ray33ee/RadiatorController/readme.md

# RadiatorController

A home made WiFi operated radiator valve controller made using a Danfoss Eco enclosure and motor.
