ray33ee/RadiatorController/Front/front/front.kicad_pcb

## KiCad design Front/front/front.kicad_pcb (2021-11-04)

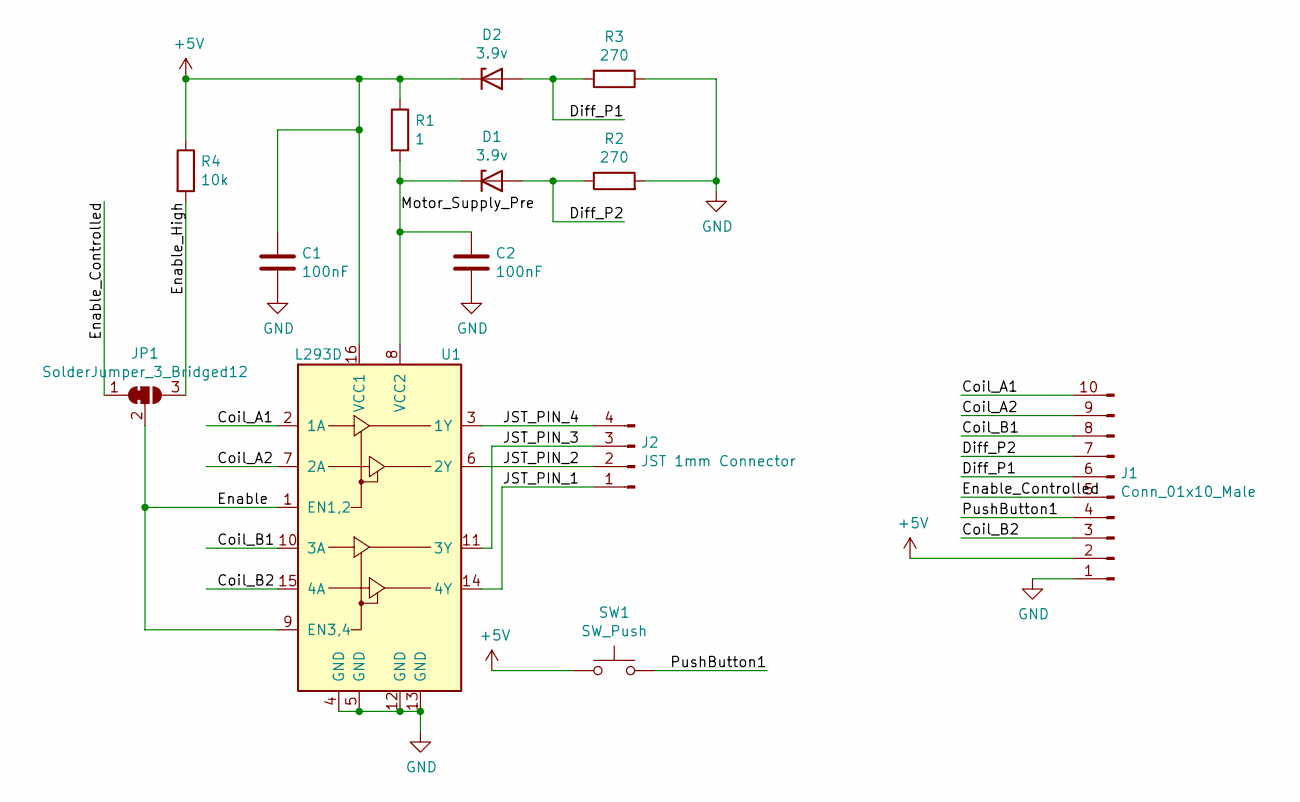
[picture p1: schematic front.sch]

Parts:
C1, C2: 100nF; C_1206_3216Metric_Pad1.33x1.80mm_HandSolder
D1, D2: 3.9v; D_MiniMELF
J1: Conn_01x10_Male; PinHeader_1x10_P2.54mm_Vertical
J2: JST 1mm Connector; JST_SH_SM04B-SRSS-TB_1x04-1MP_P1.00mm_Horizontal
JP1: SolderJumper_3_Bridged12; SolderJumper-3_P1.3mm_Bridged12_RoundedPad1.0x1.5mm_NumberL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
R1: 1; R_1206_3216Metric_Pad1.30x1.75mm_HandSolder
R2, R3: 270; R_1206_3216Metric_Pad1.30x1.75mm_HandSolder
R4: 10k; R_1206_3216Metric_Pad1.30x1.75mm_HandSolder
SW1: SW_Push; SW_Push_SPST_NO_Alps_SKRK
U1: L293D; DIP-16_W7.62mm

Connections:
+5V: C1.1, D2.1 (K), J1.2, R1.1, R4.1, SW1.1, U1.16 (VCC1)
/Coil_A1: J1.10, U1.2 (1A)
/Coil_A2: J1.9, U1.7 (2A)
/Coil_B1: J1.8, U1.10 (3A)
/Coil_B2: J1.3, U1.15 (4A)
/Diff_P1: D2.2 (A), J1.6, R3.2
/Diff_P2: D1.2 (A), J1.7, R2.1
/Enable: JP1.2 (C), U1.1 (EN1,2), U1.9 (EN3,4)
/Enable_Controlled: J1.5, JP1.1 (A)
/Enable_High: JP1.3 (B), R4.2
/JST_PIN_1: J2.1, U1.14 (4Y)
/JST_PIN_2: J2.2, U1.6 (2Y)
/JST_PIN_3: J2.3, U1.11 (3Y)
/JST_PIN_4: J2.4, U1.3 (1Y)
/Motor_Supply_Pre: C2.1, D1.1 (K), R1.2, U1.8 (VCC2)
/PushButton1: J1.4, SW1.2
GND: C1.2, C2.2, J1.1, R2.2, R3.1, U1.4 (GND), U1.5 (GND), U1.12 (GND), U1.13 (GND)

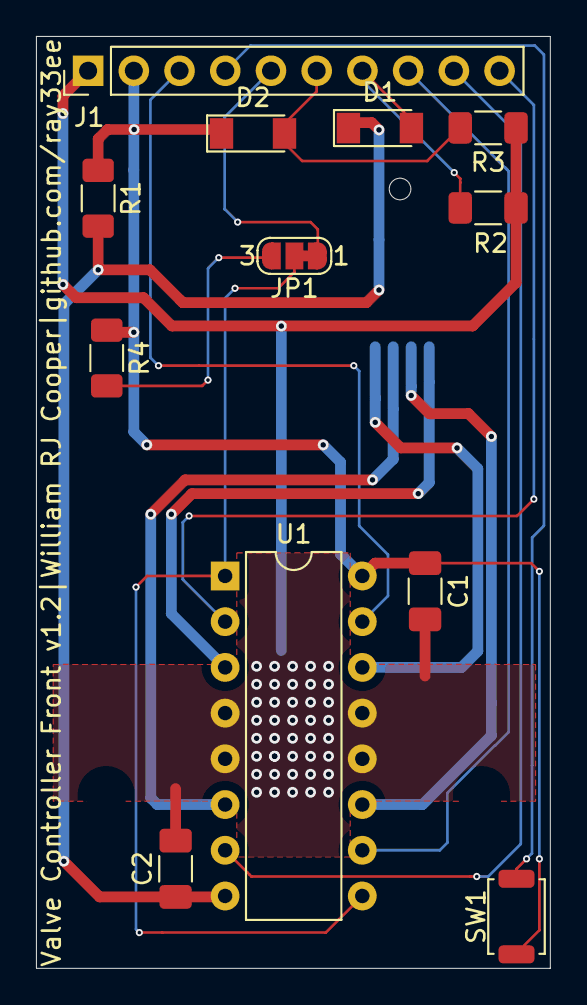
[picture p2: board front.kicad_pcb from above]

Board: 2 copper layers, 28.5 x 51.8 mm, 13 parts (1 on the bottom side), 17 nets.
