ray33ee/RadiatorController/Side/side/side.kicad_pcb

## KiCad design Side/side/side.kicad_pcb (2021-11-02)

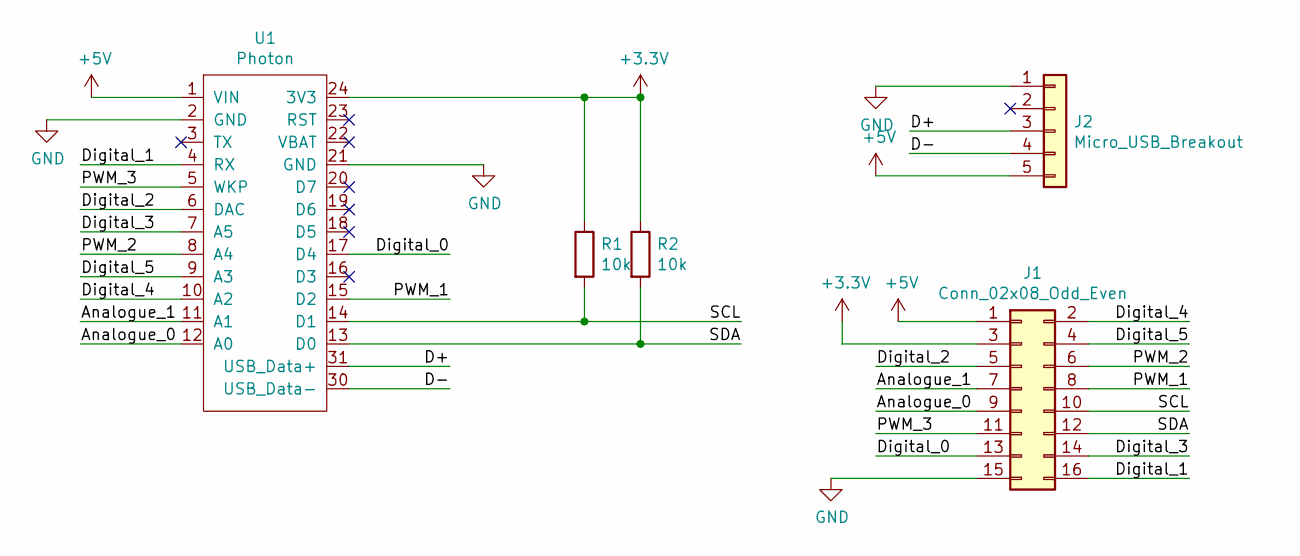
[picture p3: schematic side.sch]

Parts:
J1: Conn_02x08_Odd_Even; PinHeader_2x08_P2.54mm_Vertical
J2: Micro_USB_Breakout; Adafruit_Micro_USB_Breakout_copy
R1, R2: 10k; R_1206_3216Metric_Pad1.30x1.75mm_HandSolder
U1: Photon

Connections:
+3V3: J1.3, R1.1, R2.1, U1.24 (3V3)
+5V: J1.1, J2.5, U1.1 (VIN)
/Analogue_0: J1.9, U1.12 (A0)
/Analogue_1: J1.7, U1.11 (A1)
/D+: J2.3, U1.31 (USB_Data+)
/D-: J2.4, U1.30 (USB_Data-)
/Digital_0: J1.13, U1.17 (D4)
/Digital_1: J1.16, U1.4 (RX)
/Digital_2: J1.5, U1.6 (DAC)
/Digital_3: J1.14, U1.7 (A5)
/Digital_4: J1.2, U1.10 (A2)
/Digital_5: J1.4, U1.9 (A3)
/PWM_1: J1.8, U1.15 (D2)
/PWM_2: J1.6, U1.8 (A4)
/PWM_3: J1.11, U1.5 (WKP)
/SCL: J1.10, R1.2, U1.14 (D1)
/SDA: J1.12, R2.2, U1.13 (D0)
GND: J1.15, J2.1, U1.2 (GND), U1.21 (GND)

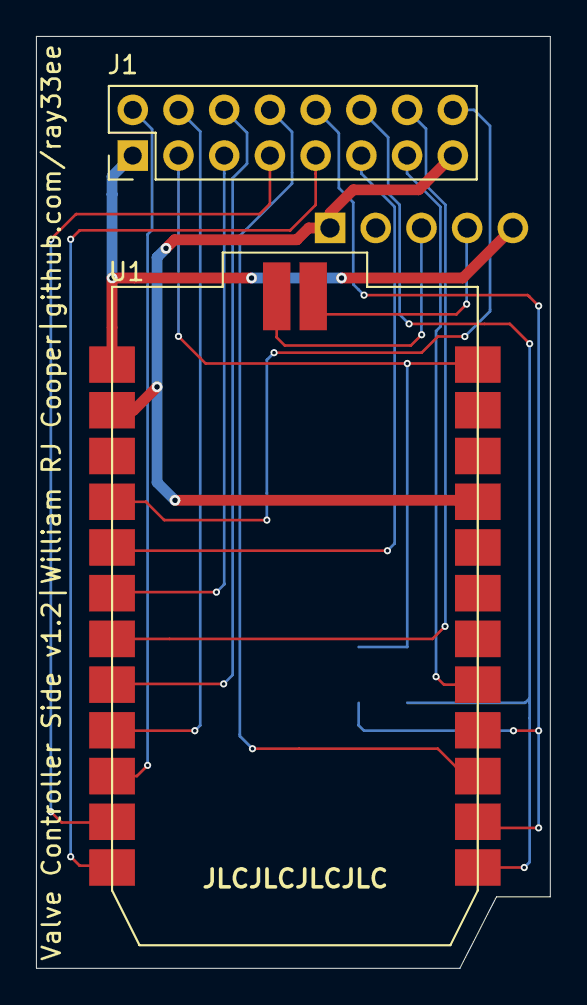
[picture p4: board side.kicad_pcb from above]

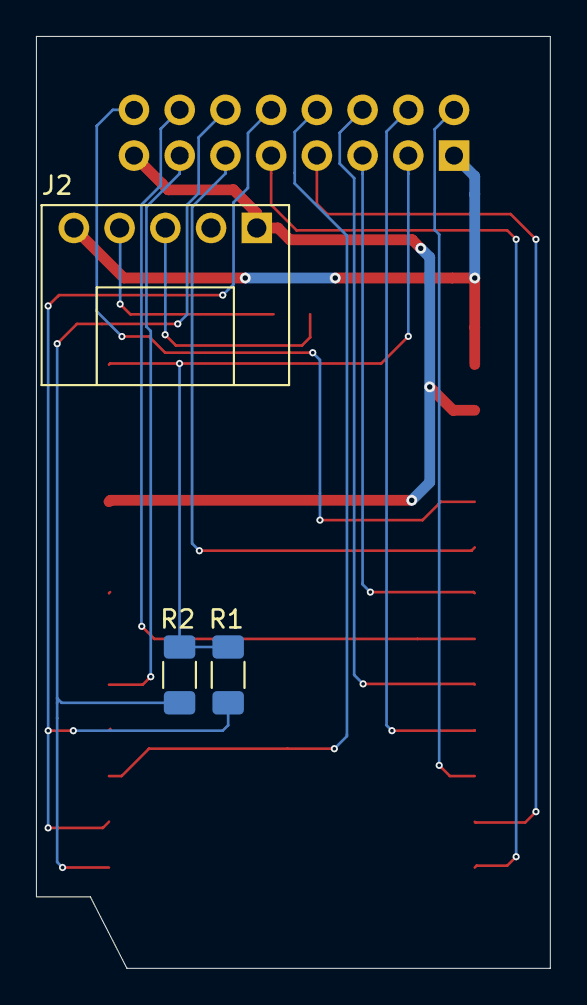
[picture p5: board side.kicad_pcb from below]

Board: 2 copper layers, 28.5 x 51.8 mm, 5 parts (3 on the bottom side), 18 nets.
