ray33ee/RadiatorController/Top/top/top.kicad_pcb

## KiCad design Top/top/top.kicad_pcb (2021-11-17)

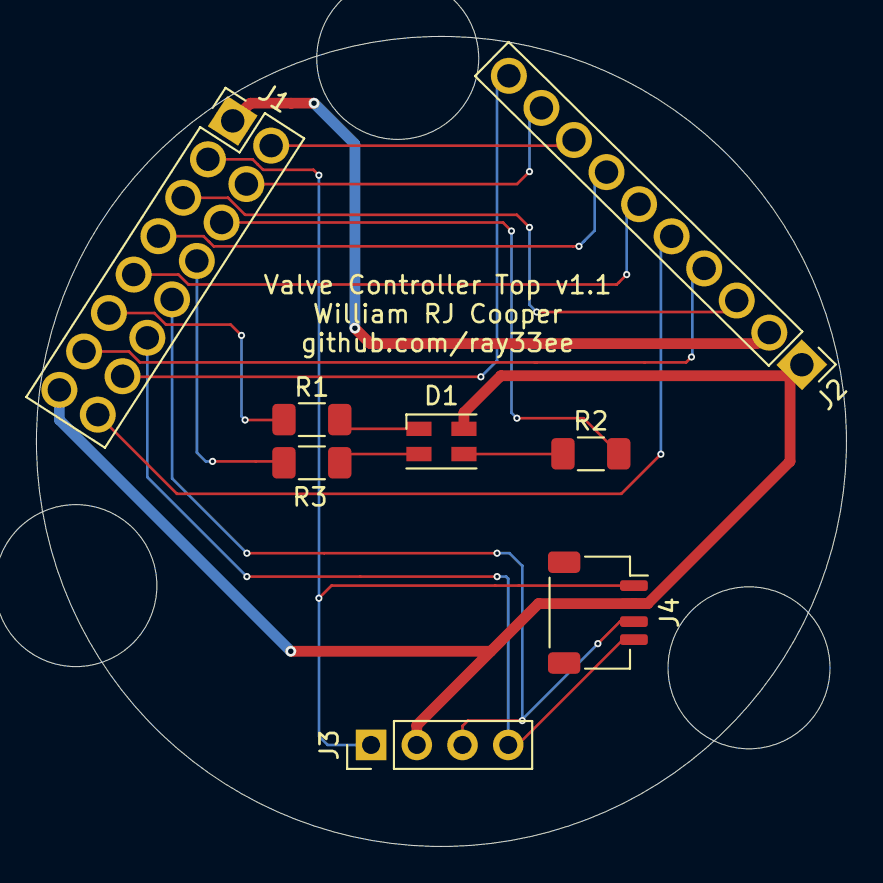
[picture p6: board top.kicad_pcb from above]

Board: 2 copper layers, 45.0 x 45.0 mm, 11 parts (0 on the bottom side), 19 nets.

Parts:
D1: LED_RBGA; LED_Cree-PLCC4_3.2x2.88mm_CCW_Hand_Solder
J1: Conn_02x08_Odd_Even; PinHeader_2x08_P2.54mm_Vertical
J2: Conn_01x10_Female; PinHeader_1x10_P2.54mm_Vertical
J3: Header; PinHeader_1x04_P2.54mm_Vertical
J4: JST Connector; JST_SH_SM04B-SRSS-TB_1x04-1MP_P1.00mm_Horizontal
MH1, MH2, MH3: GenericMountingHole
R1: 680; R_1206_3216Metric_Pad1.30x1.75mm_HandSolder
R2, R3: 470; R_1206_3216Metric_Pad1.30x1.75mm_HandSolder

Connections:
+3V3: J1.3, J3.1, J4.1
+5V: J1.1, J2.2
/B: D1.2, R3.1
/Coil_A1: J1.14, J2.10
/Coil_A2: J1.4, J2.9
/Coil_B1: J1.2, J2.8
/Coil_B2: J1.5, J2.3
/Diff_P1: J1.9, J2.6
/Diff_P2: J1.7, J2.7
/Enabled_Controlled: J1.16, J2.5
/G: D1.3, R2.1
/LED_Blue: J1.8, R3.2
/LED_Green: J1.6, R2.2
/LED_Red: J1.11, R1.2
/PushButton: J1.13, J2.4
/R: D1.1, R1.1
/SCL: J1.10, J3.3, J4.3
/SDA: J1.12, J3.4, J4.4
GND: D1.4, J1.15, J2.1, J3.2, J4.2
