ray33ee/RadiatorController/valve.cpp

#include "valve.h"

//Uncomment this line to enable debugging options
#define __DEBUG__

Valve::Valve(/*pin_t a1, int a2, int b1, int b2, int p1, int p2, int enable*/) {
    
    /* Initialise pins */
    
    //Setup the control pins
    pinMode(A5, OUTPUT);
    pinMode(A3, OUTPUT);
    pinMode(A2, OUTPUT);
    pinMode(DAC, OUTPUT);
    
    pinMode(RX, OUTPUT);
    
    //Enable the L293D driver
    //digitalWrite(D0, HIGH);
    
    //Start the system deenergised
    deenergise();
    
    /*_a1 = a1;
    _a2 = a2;
    _b1 = b1;
    _b2 = b2;
    _p1 = p1;
    _p2 = p2;
    _enable = enable;*/
    
    /* Startup sequence */
    
    current_cutoff = learn();
    
    //Retract fully or until the plunger bottoms out. This garuntees that after this call, the plunger will be at position 0
    retract(ABSOLUTE_MAXIMUM_BLOCKS);
    
    //At this point progress should be zero
    _position = 0;
    
    //Push to the absolute maximum, or until the plunger stops
    push(ABSOLUTE_MAXIMUM_BLOCKS);
    
    //This position is the new maximum.
    //We subtract two because sometimes the current sensing circuit stops the plunger before it can get to this point, if the plunger is already close to it
    _max_position = position() - 2;
    
}

//Set the driver input values
void Valve::set_coils(int a1, int a2, int b1, int b2) {
    
    digitalWrite(A5, a1);
    digitalWrite(A3, a2);
    digitalWrite(A2, b1);
    digitalWrite(DAC, b2);
    
}

void Valve::deenergise() {
    set_coils(0,0,0,0);
}

int Valve::delay_and_sample(int delay, int* cumulative) {
    int start = micros();
    
    int p1 = analogRead(A1);
    int p2 = analogRead(A0);
    int diff = p2 - p1;
    
    *cumulative += diff;

    int duration  = micros() - start;
    
    delayMicroseconds(STEP_DURATION - duration);
    
    return 0;
}

void Valve::enable_driver(bool e) {
    digitalWrite(RX, e);
}

int Valve::retract(int blocks) {
    
    enable_driver(true);
    
    noInterrupts();
    
    for (int j = 0; j < blocks; ++j) {
        
        int total = 0;
        
        for (int i = 0; i < 15; ++i) {
            set_coils(1, 0, 1, 0);
            delay_and_sample(STEP_DURATION, &total);
            set_coils(0, 1, 1, 0);
            delay_and_sample(STEP_DURATION, &total);
            set_coils(0, 1, 0, 1);
            delay_and_sample(STEP_DURATION, &total);
            set_coils(1, 0, 0, 1);
            delay_and_sample(STEP_DURATION, &total);
        }
        
        if (total < current_cutoff) {
            interrupts();
            deenergise();
            enable_driver(false);
            return total;   
        }
        
        _position -= 1;
    }
    
    interrupts();
    deenergise();
    enable_driver(false);
    return 0;
}

int Valve::push(int blocks) {
    
    enable_driver(true);
    
    noInterrupts();

    for (int j = 0; j < blocks; ++j) {
        
        int total = 0;
        
        for (int i = 0; i < 15; ++i) {
            set_coils(1, 0, 0, 1);
            delay_and_sample(STEP_DURATION, &total);
            set_coils(0, 1, 0, 1);
            delay_and_sample(STEP_DURATION, &total);
            set_coils(0, 1, 1, 0);
            delay_and_sample(STEP_DURATION, &total);
            set_coils(1, 0, 1, 0);
            delay_and_sample(STEP_DURATION, &total);
        }
        
        if (total < current_cutoff) { 
            interrupts();
            deenergise();
            enable_driver(false);
            return total;   
        }
        
        _position += 1;
        
    }
    
    interrupts();
    deenergise();
    enable_driver(false);
    return 0;
}

int Valve::retract_block(int blocks) {
    
    int total = 0;
    
    for (int j = 0; j < blocks; ++j) {
        for (int i = 0; i < 15; ++i) {
            set_coils(1, 0, 1, 0);
            delay_and_sample(STEP_DURATION, &total);
            set_coils(0, 1, 1, 0);
            delay_and_sample(STEP_DURATION, &total);
            set_coils(0, 1, 0, 1);
            delay_and_sample(STEP_DURATION, &total);
            set_coils(1, 0, 0, 1);
            delay_and_sample(STEP_DURATION, &total);
        }
    }
    
    return total;
}

int Valve::push_block(int blocks) {
    
    int total = 0;

    for (int j = 0; j < blocks; ++j) {
        for (int i = 0; i < 15; ++i) {
            set_coils(1, 0, 0, 1);
            delay_and_sample(STEP_DURATION, &total);
            set_coils(0, 1, 0, 1);
            delay_and_sample(STEP_DURATION, &total);
            set_coils(0, 1, 1, 0);
            delay_and_sample(STEP_DURATION, &total);
            set_coils(1, 0, 1, 0);
            delay_and_sample(STEP_DURATION, &total);
        }
    }
    
    return total;
}

int Valve::learn() {
    
    //Basically we just push/retract until we have current totals far enough apart that we can be confident that between them is the current cutoff
    
    
    enable_driver(true);
    
    noInterrupts();

    int push_average = push_block(1);
    deenergise();
    delay(50);  
    
    retract_block(1);
    deenergise();
    delay(50);  
    
    int retract_average = retract_block(1);
    deenergise();
    delay(50);  
    
    int middle = (float)(push_average + retract_average) / 2.0f;
    
    int diff = push_average - retract_average;
    
    if (abs(diff) < 2000) {
        
        //Keep retracting until..
        
        for (int i = 0; i < 50; ++i) {
            
            int retract = retract_block(1);
            
            int diff = middle - retract;
            
            if (abs(diff) > 2000) {
                
                middle = (float)(retract + middle) / 2.0f;
                break;
                
            }
            
        }
        
    }
    
    interrupts();
    deenergise();
    enable_driver(false);
    
    return middle;
}
    
int Valve::test_push(int blocks) {
    
    enable_driver(true);
    
    noInterrupts();
    
    int total = push_block(blocks);
    
    interrupts();
    deenergise();
    enable_driver(false);
    return total;
}

int Valve::test_retract(int blocks) {
    enable_driver(true);
    
    noInterrupts();
    
    int total = retract_block(blocks);
    
    interrupts();
    deenergise();
    enable_driver(false);
    return total;
}

    
//Move to the desired positions
int Valve::setPosition(int position) {
    //Bounds check
    if (position < 0 || position > _max_position) {
        return -1;
    } 
    
    if (position < _position) {
        
        retract(_position - position);
        
    } else if (position > _position) {
        
        push(position - _position);
        
    }
    
    return 0;
}

//Return the current posision
int Valve::position() const {
    return _position;
}

//Return the maximum position learned at startup
int Valve::max_position() const {
    return _max_position;
}

int Valve::open_valve() {
    return setPosition(0);
}

int Valve::close_valve() {
    return setPosition(_max_position);
}
