ray33ee/RadiatorController/(commit log)

2021-10-16 Version 0.1.1 - Various changes, see changelog
    [front.kicad_pcb, front.sch]
2021-10-17 Version 0.1.2 - First draft of front PCB complete
    [front.kicad_pcb, front.sch]
2021-10-18 Version 0.1.3 - Various changes, see changelog
    [front.kicad_pcb, front.sch]
2021-10-19 Version 0.1.4 - Various changes, see changelog
    [front.kicad_pcb, side.kicad_pcb, side.sch, top.kicad_pcb, top.sch]
2021-10-19 Version 0.1.5 - Various changes, see changelog
    [front.kicad_pcb, side.kicad_pcb, side.sch, top.kicad_pcb]
2021-10-21 Version 0.1.7 - Various changes, see changelog
    [front.kicad_pcb, front.sch, side.kicad_pcb, side.sch, top.kicad_pcb]
2021-10-23 Version 0.1.8 - Various changes, see changelog
    [top.kicad_pcb]
2021-10-31 Version 0.1.14 - Various changes, see changelog
    [side.kicad_pcb, side.sch, top.kicad_pcb]
2021-11-02 Version 0.1.15 - Various changes, see changelog
    [front.kicad_pcb, front.sch, side.kicad_pcb, top.kicad_pcb]
2021-11-04 Version 0.1.16 - Various changes, see changelog
    [front.kicad_pcb, front.sch, motor.kicad_pcb, motor.sch]
2021-11-17 Version 0.1.17 - Modified code to accomodate Front/Side/Board PCBs
    [top.kicad_pcb]
